ruffner/globe-clock/README.md

# globe-clock
Wireless Persistence of Vision Advertising Solution

See the docs folder for presentations from the course, as well as design reports which include imagery.
