ruffner/globe-clock/images/hello-mapped.png

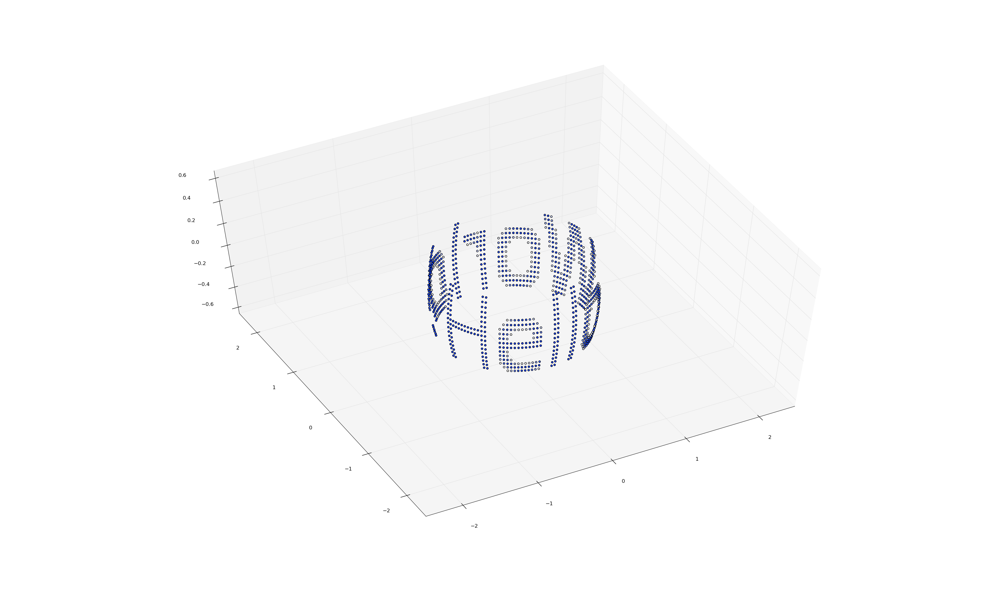
images/hello-mapped.png
