ruffner/globe-clock/images/orca-mapped.png

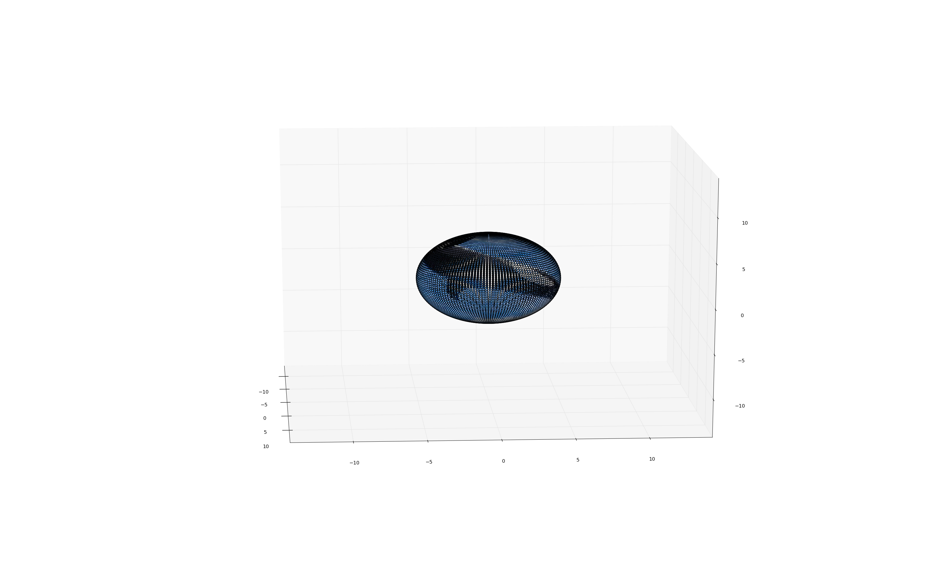
images/orca-mapped.png
