ruffner/globe-clock/images/pointmap.png

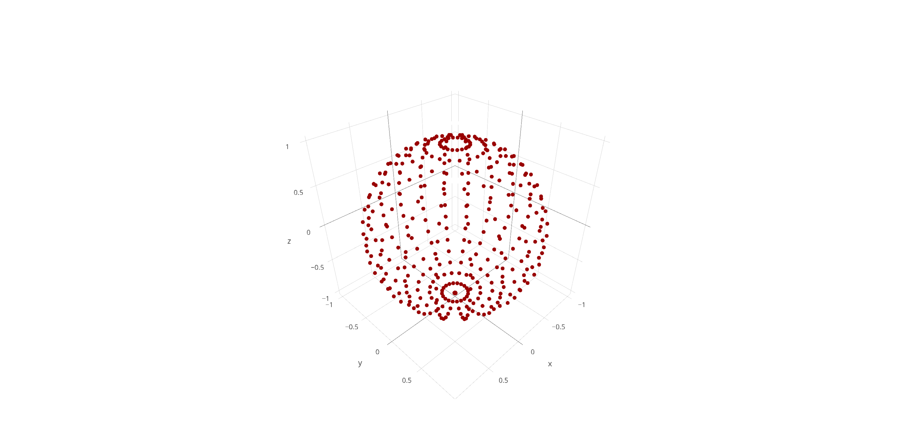
images/pointmap.png
