ruffner/globe-clock/CAD/bottom_anchor.stl

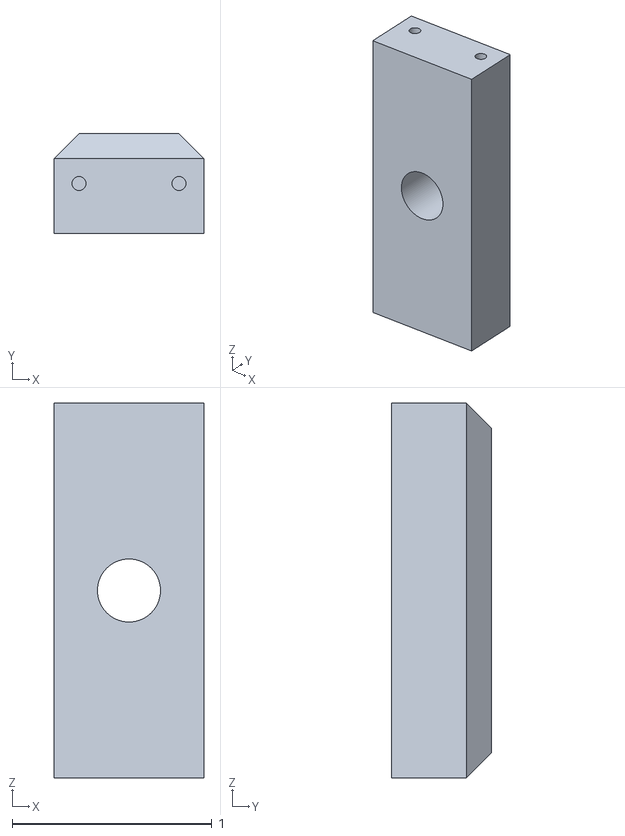
[picture p25: CAD file, 2016-03-02]
CAD/bottom_anchor.stl
0.75 x 0.5 x 1.88
