ruffner/globe-clock/CAD/led_clip_v2.stl

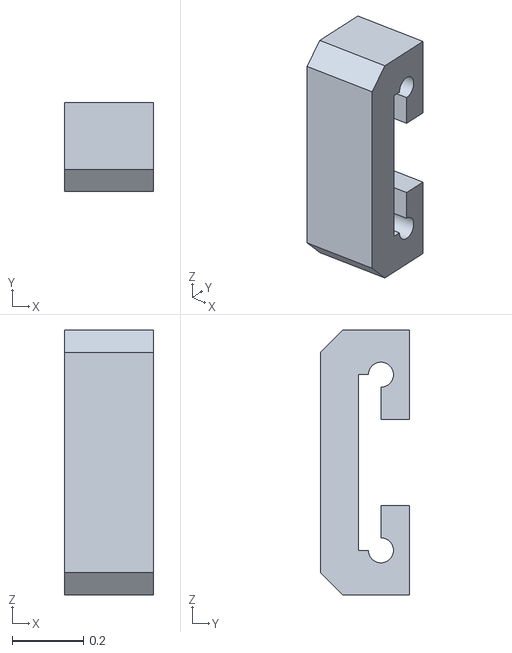
[picture p26: CAD file, 2016-03-02]
CAD/led_clip_v2.stl
0.25 x 0.25 x 0.742
