ruffner/globe-clock/CAD/base_segment.stl

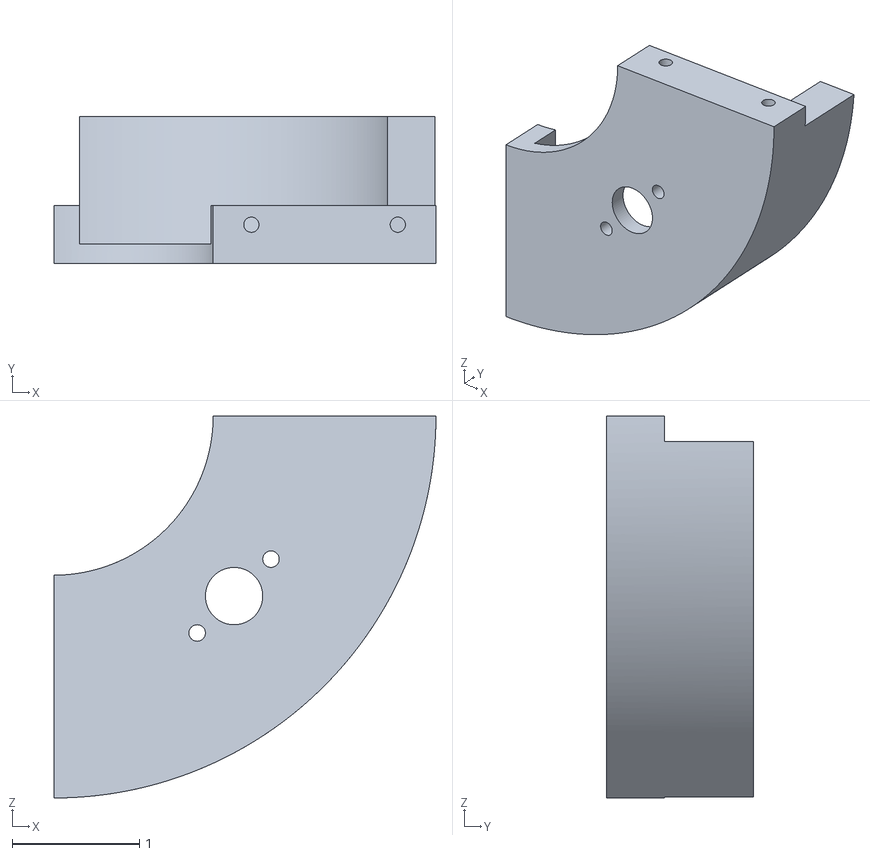
[picture p27: CAD file, 2016-03-02]
CAD/base_segment.stl
3.00 x 1.15 x 3.00
