ruffner/globe-clock/CAD/sleeve_support.stl

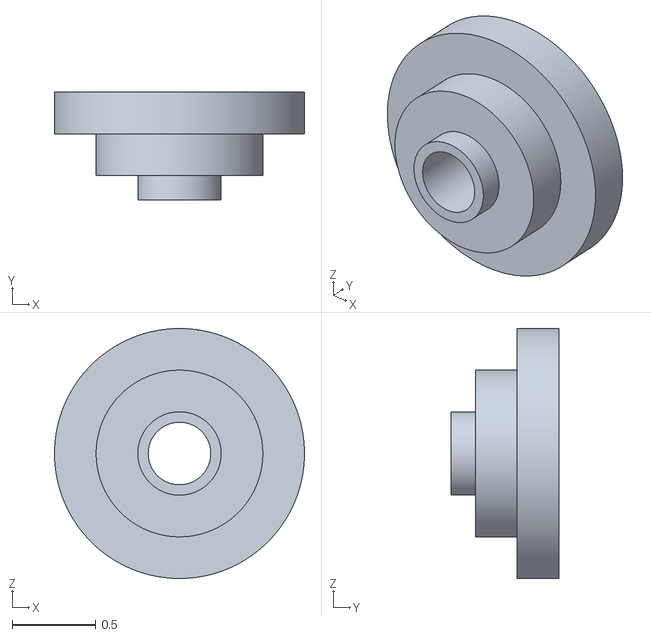
[picture p28: CAD file, 2016-03-02]
CAD/sleeve_support.stl
1.50 x 0.645 x 1.50
