ruffner/globe-clock/CAD/band_hinge.stl

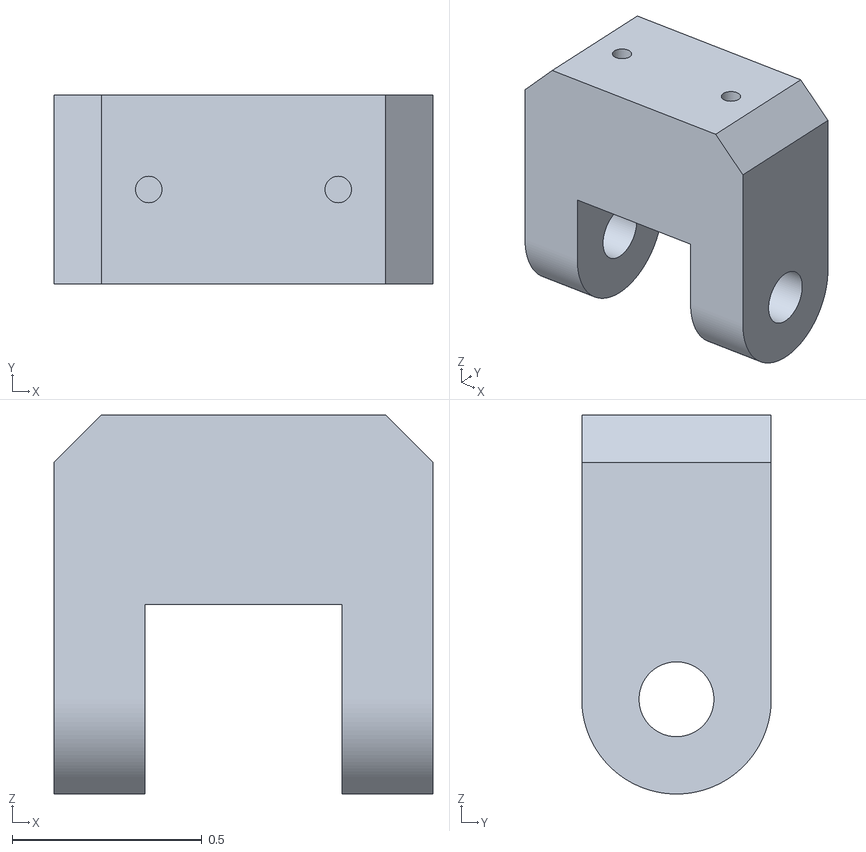
[picture p29: CAD file, 2016-03-02]
CAD/band_hinge.stl
1.00 x 0.5 x 1
