ruffner/globe-clock/CAD/hinge_pin.stl

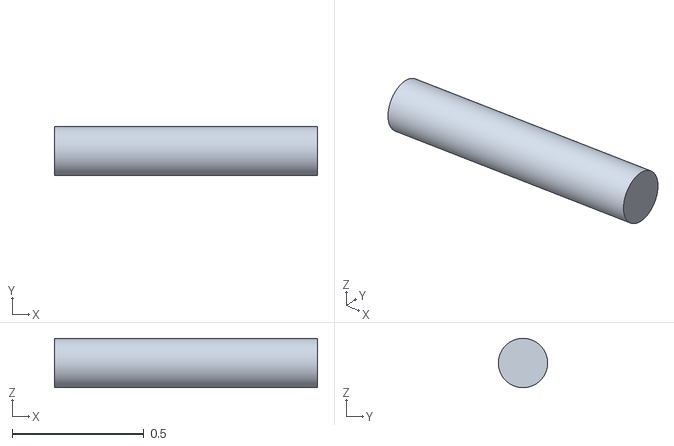
[picture p30: CAD file, 2016-03-02]
CAD/hinge_pin.stl
1.00 x 0.187 x 0.187
