ruffner/globe-clock/CAD/center.stl

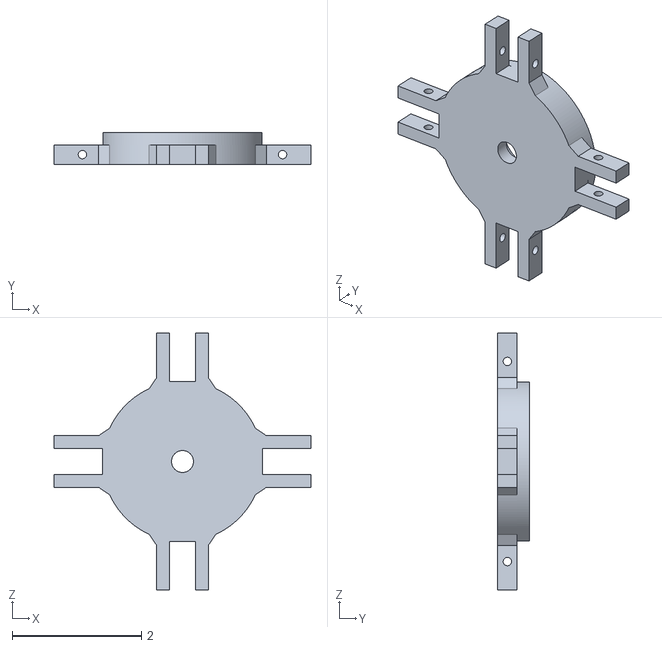
[picture p31: CAD file, 2016-03-02]
CAD/center.stl
3.98 x 0.49 x 3.98
