ruffner/globe-clock/CAD/top_anchor.stl

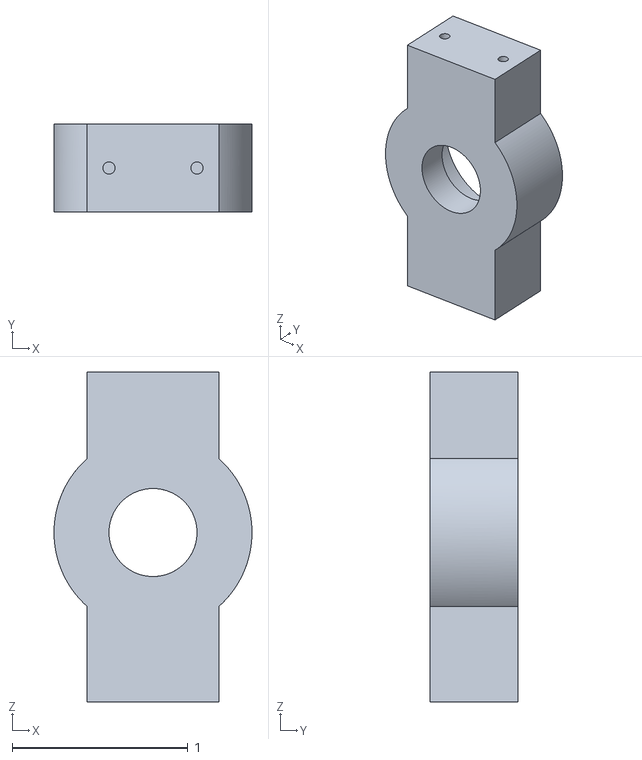
[picture p32: CAD file, 2016-03-02]
CAD/top_anchor.stl
1.12 x 0.5 x 1.88
