ruffner/globe-clock/CAD/top_anchor_v3.stl

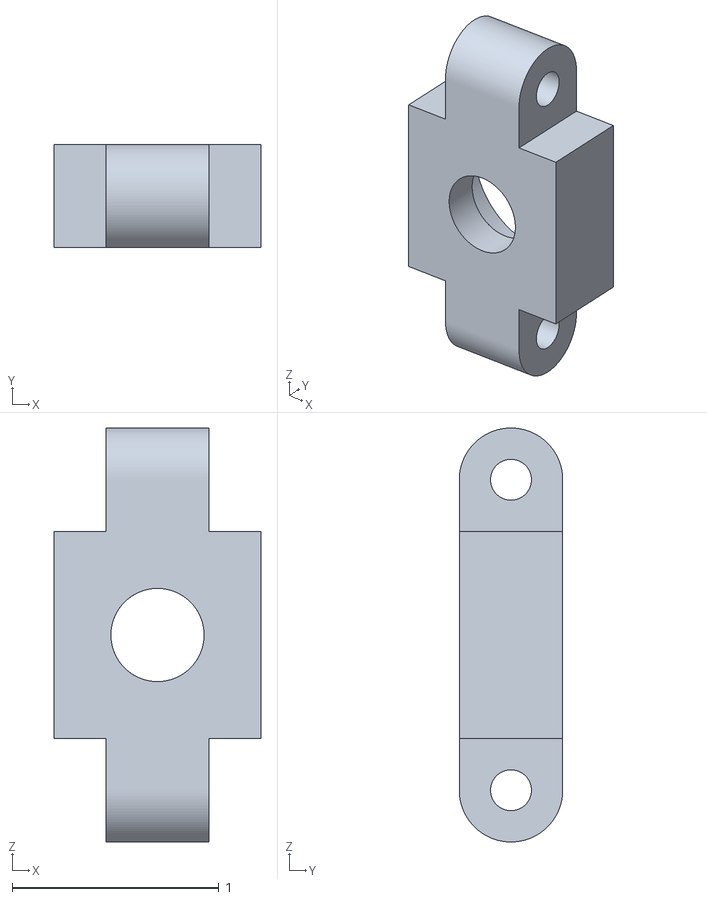
[picture p33: CAD file, 2016-03-02]
CAD/top_anchor_v3.stl
1.00 x 0.5 x 2.00
