ruffner/globe-clock/CAD/led_clip.stl

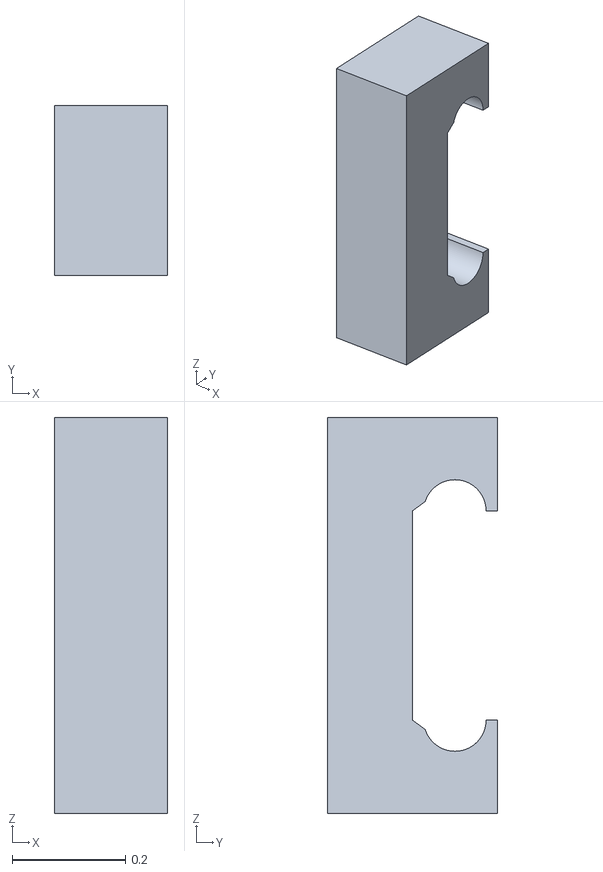
[picture p34: CAD file, 2016-03-02]
CAD/led_clip.stl
0.2 x 0.3 x 0.7
