ruffner/globe-clock/(list of files, cad)

Other CAD files:
CAD/bottom_anchor_v3.stl
CAD/band_hinge.ipt
CAD/base_segment.ipt
CAD/bottom_anchor.dwg
CAD/bottom_anchor.ipt
CAD/bottom_anchor_v3.ipt
CAD/center.ipt
CAD/hinge_pin.ipt
CAD/led_clip.ipt
CAD/led_clip_v2.ipt
CAD/sleeve_support.dwg
CAD/sleeve_support.ipt
CAD/top_anchor.dwg
CAD/top_anchor.ipt
CAD/top_anchor_v3.ipt
