ruffner/globe-clock/eagle/orbit-board/orbit-board.sch

## EAGLE design eagle/orbit-board/orbit-board.sch (2016-02-22)

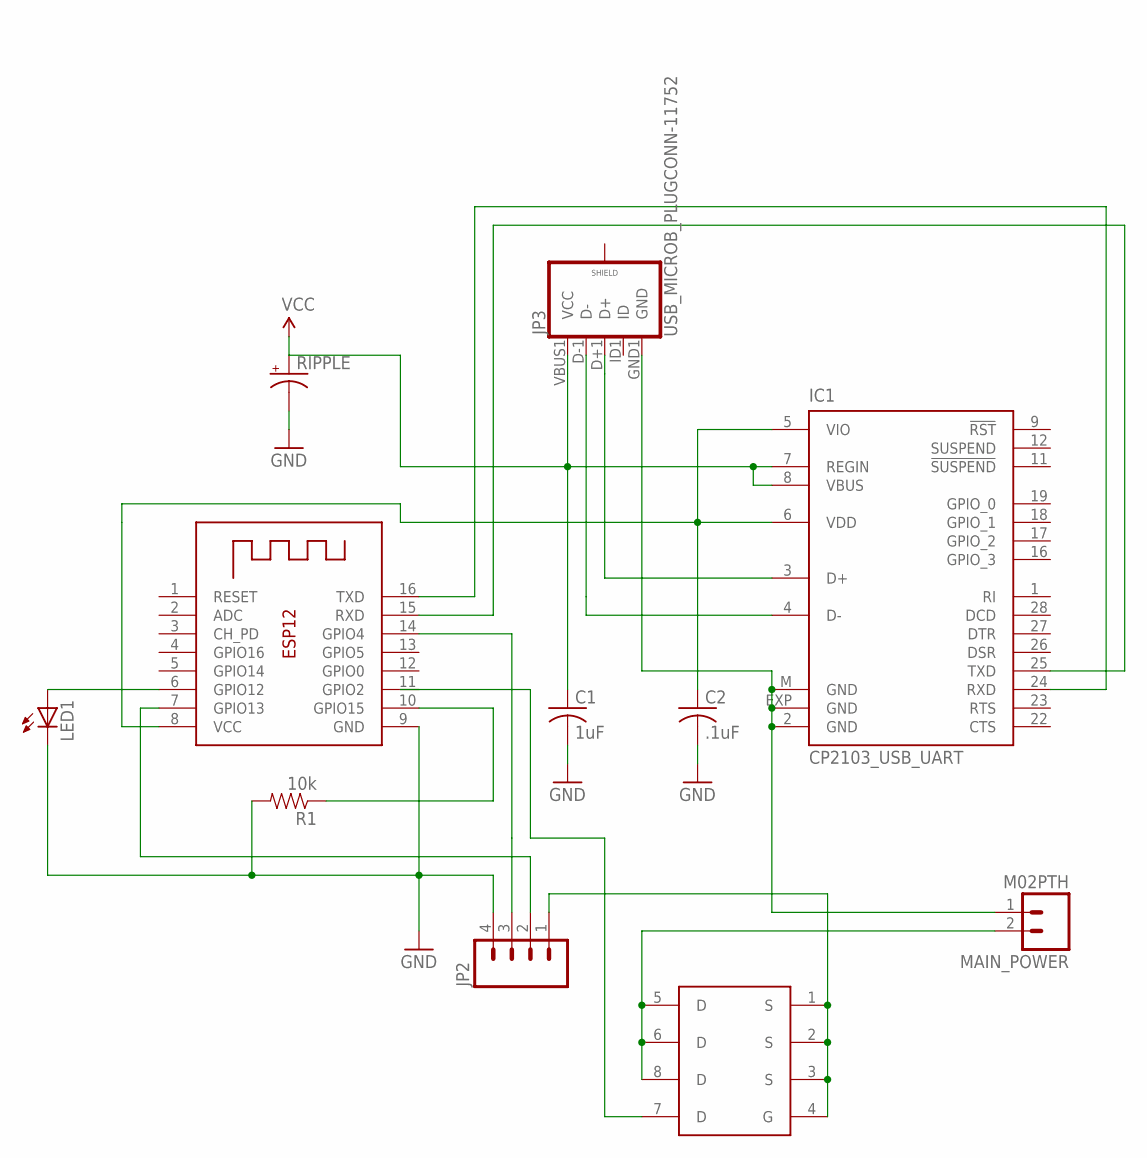
[picture p35: schematic orbit-board.sch]

Parts:
C1: 1uF; C0603
C2: .1uF; C0603
IC1: CP2103_USB_UART; MLP28
JP2: M04PTH; 1X04
JP3: USB_MICROB_PLUGCONN-11752; USB-B-MICRO-SMD_V03
LED1: LEDSML1206; SML1206
MAIN_POWER: M02PTH; 1X02
R1: 10k; 0603-RES
RIPPLE: CAP_POLPTH2; CPOL-RADIAL-10UF-25V
U$1: NDS8434; SO08
X1: ESP-12

Connections:
GND: C1.2, C2.2, JP2.4, LED1.C, R1.2, RIPPLE.2 (-), X1.9 (GND)
unnamed: IC1.2 (GND), IC1.EXP (GND), IC1.M (GND), JP3.GND1 (GND), MAIN_POWER.1
unnamed: IC1.3 (D+), JP3.D+1 (D+)
unnamed: IC1.4 (D-), JP3.D-1 (D-)
unnamed: C2.1, IC1.5 (VIO), IC1.6 (VDD), X1.8 (VCC)
unnamed: LED1.A, X1.6 (GPIO12)
unnamed: JP2.3, X1.14 (GPIO4)
unnamed: JP2.2, X1.7 (GPIO13)
unnamed: IC1.24 (RXD), X1.16 (TXD)
unnamed: IC1.25 (TXD), X1.15 (RXD)
unnamed: R1.1, X1.10 (GPIO15)
unnamed: MAIN_POWER.2, U$1.5 (D), U$1.6 (D), U$1.8 (D)
unnamed: JP2.1, U$1.1 (S), U$1.2 (S), U$1.3 (S), U$1.4 (G)
VCC: C1.1, IC1.7 (REGIN), IC1.8 (VBUS), JP3.VBUS1 (VCC), RIPPLE.1 (+)
