ruffner/globe-clock/(commit log)

2016-02-02 Added beginning of on board PCB design.
    [orbit-board.sch]
2016-02-11 added programming header and LDO 3.3V regulator
    [orbit-board.sch]
2016-02-19 added cp2103 and mosfet for led power control
    [orbit-board.sch]
2016-02-19 fixed pulldown
    [orbit-board.sch]
2016-03-02 added cad and corresponding stls
    [band_hinge.ipt, band_hinge.stl, base_segment.ipt, base_segment.stl, bottom_anchor.dwg, bottom_anchor.ipt, bottom_anchor.stl, bottom_anchor_v3.ipt]
2016-04-04 added ledserver and telnet lua files, updated init file to run ledserver
